kaos-69/Mimisbrunnur/images/light.jpg

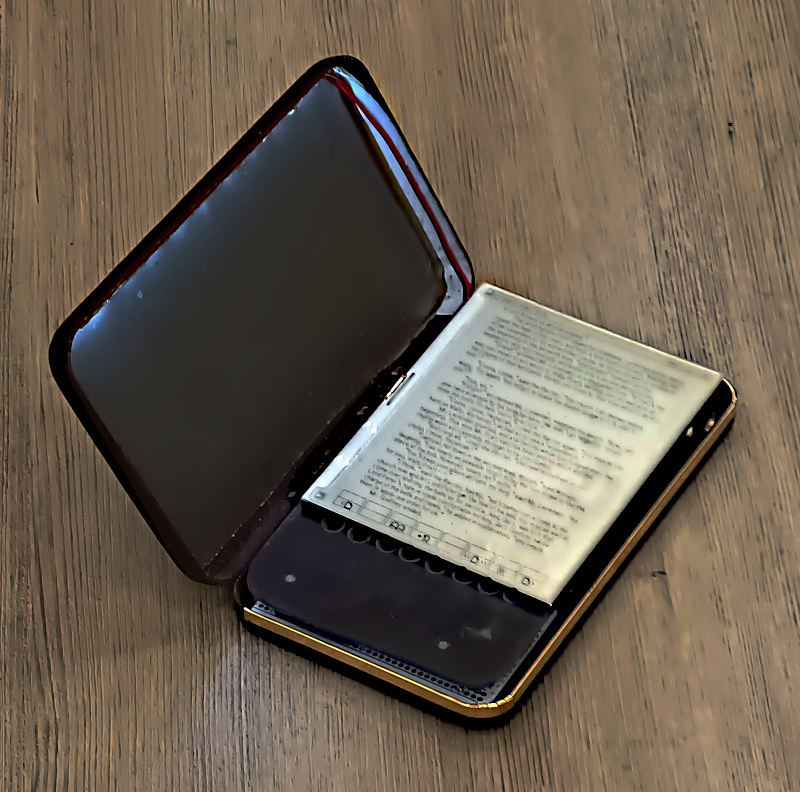
images/light.jpg
