kaos-69/Mimisbrunnur/images/reference.jpg

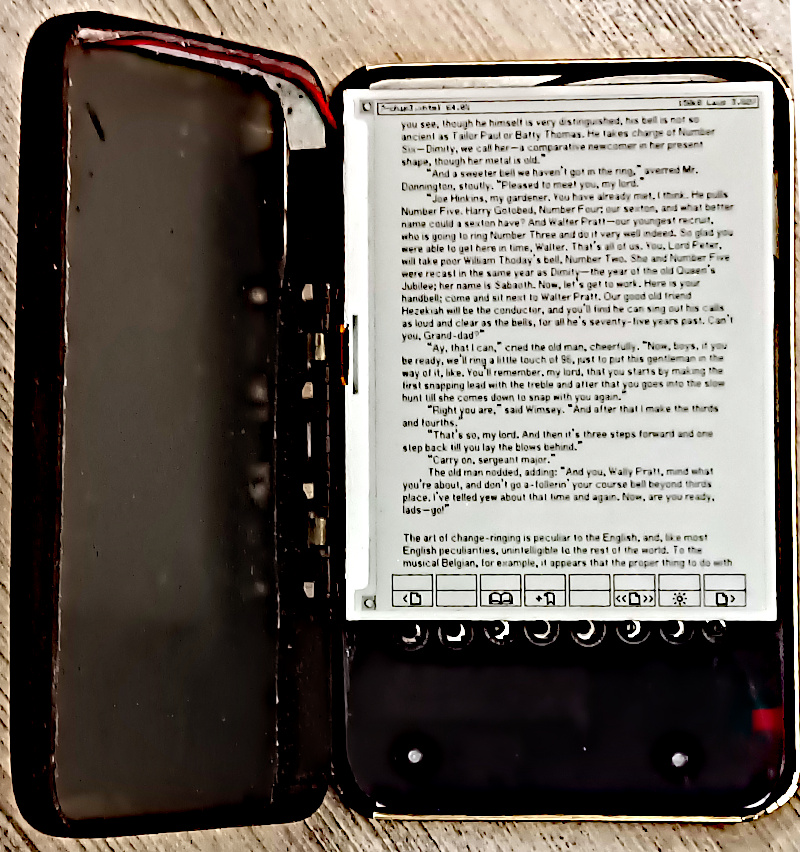
images/reference.jpg
