kaos-69/Mimisbrunnur/docs/INSTRUCTIONS.md

It may sound ass-forwards to provide operating instructions for something that there only exists one example of, and that in a constant flux of development, but I think they can provide a sense of what the reader is and how it works, and thereby whether anyone would want to dive down the rabbit hole and make something similar.

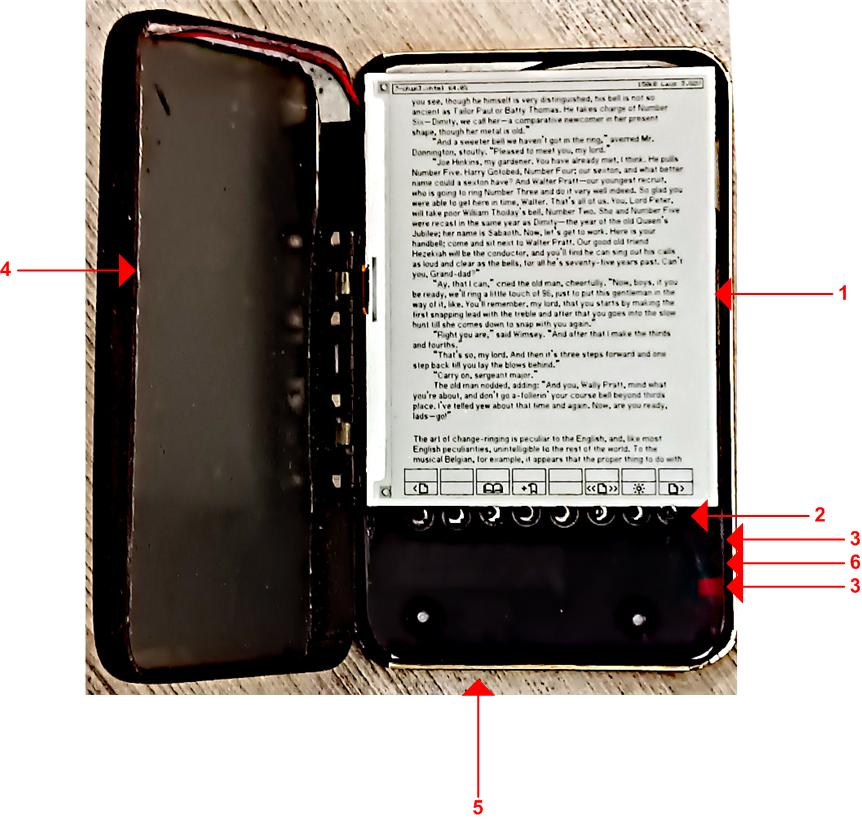
[picture p11: images/Mímisbrunnur - overview.jpg]
Mímisbrunnur overview
<br>**Overview.**  
1: An e-paper display  
2: A set of eight push buttons  
3: Two indicator lights  
4: A reading light  
5: A micro-SD slot/card to hold documents  
6: A USB-C connector for charging and programming  

The two indicators are an amber charge indicator and a red busy indicator, both located near the USB connector. When the busy indicator is lit or flashing the buttons will not work, and the SD card may be in use and should not be removed.

At the bottom of the display is a menu corresponding to the buttons and indicating the function of each one. Each menu item can show an icon, which function is accessed by a short press of the corresponding button (see below). For numbered references on the display (directory items when browsing, or links when reading) there is also a number at the corresponding button. To acess those, hold the button for approx. 2 seconds, or until the busy indicator comes on.

When the reader is started up with a previously unread memory card, you will be presented with a browse display where you can select a document to read. If it is started without a memory card an error message is displayed. For subsequent starts the reader will return you to the document and place you were reading.

When browsing, the reader will show up to eight items (directories and/or documents) at a time. If there are more than eight items you can move between pages with the next and previous buttons. The working path is shown at the top of the screen (/ initially, for root). Items ending with / are directories. In all directories except root you will also find .. for parent directory.

When reading, likewise up to eight links are presented on each page. If there are more than eight links, the page will be curtailed and you will have to move on to the next page for subsequent links.

At the top of the display a status bar is shown. When browsing this shows the current page and number of pages in the current directory. When reading it shows the name of the current document and your place within it (in percent). Always shown is free memory and battery voltage. Note that the status bar is only updated when the display is, so the values may not be current if the reader has been left unused for a substantial time.

## Menu options:

Previous page Previous page. Used when reading or browsing for documents. Note that selecting previous page when reading near the end of a large document can take some time (a matter of econds). This is because the firmware has to scan the entire document up to that point, in order to find the start of the previous page. The busy indicator blinks rapidly while doing this.

Cancel / Back history Cancel / Back history. This is used to cancel or back away from previously selected options. F.x. when following a link within a document, this function will bring you back to your previous place. Similarly, if you started browsing for a new document, this will bring you back to reading where you left off.

Browse / Open document Browse / Open document. This allows you to select a new document for reading. You will start browsing in the directory of the document you were reading. You can return to reading where you left off by using Cancel, but once you have selected a new document, your history is deleted.

Add bookmark Remove bookmark Go to next bookmark Bookmarks. When reading, you can add or remove bookmarks for any page, and go to next bookmark after the current page. If there is no next bookmark, you will go to the first bookmark in the document.

Skip around Skip around. This allows you to skip to several points in the document, which can be useful if you want to quickly find a specific passage.

Reading light Reading light. This will turn on or off the reading light.

Next page Next page. Used when reading or browsing for documents. Unlike the previous page option, this is practically instantaneous, apart from the time it takes to display the new page.
