kaos-69/Mimisbrunnur/images/Mímisbrunnur -  layout.pdf

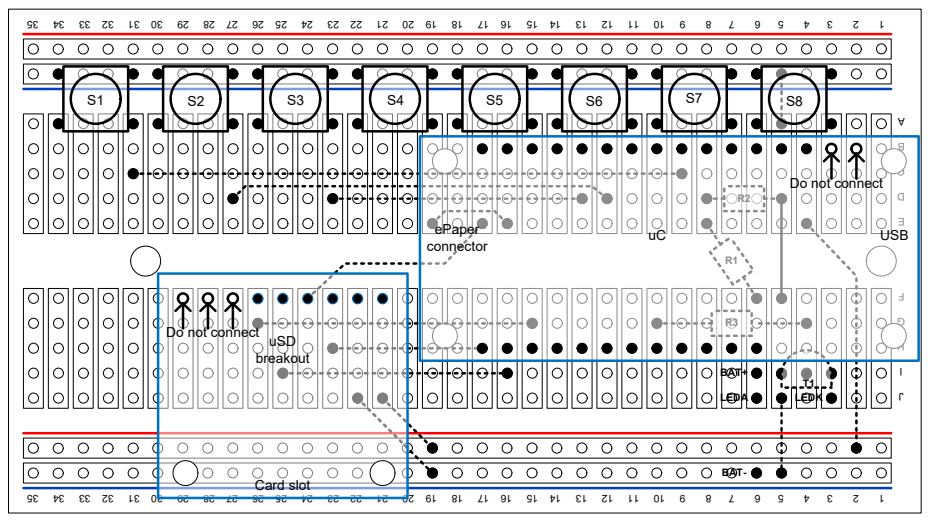
[picture p12: page 1]
LEDA; LEDK; BAT+; BAT-; USB ePaper; connector; uSD breakout; Card slot

Do not connect
