kaos-69/Mimisbrunnur/images/Mímisbrunnur -  diagram.pdf

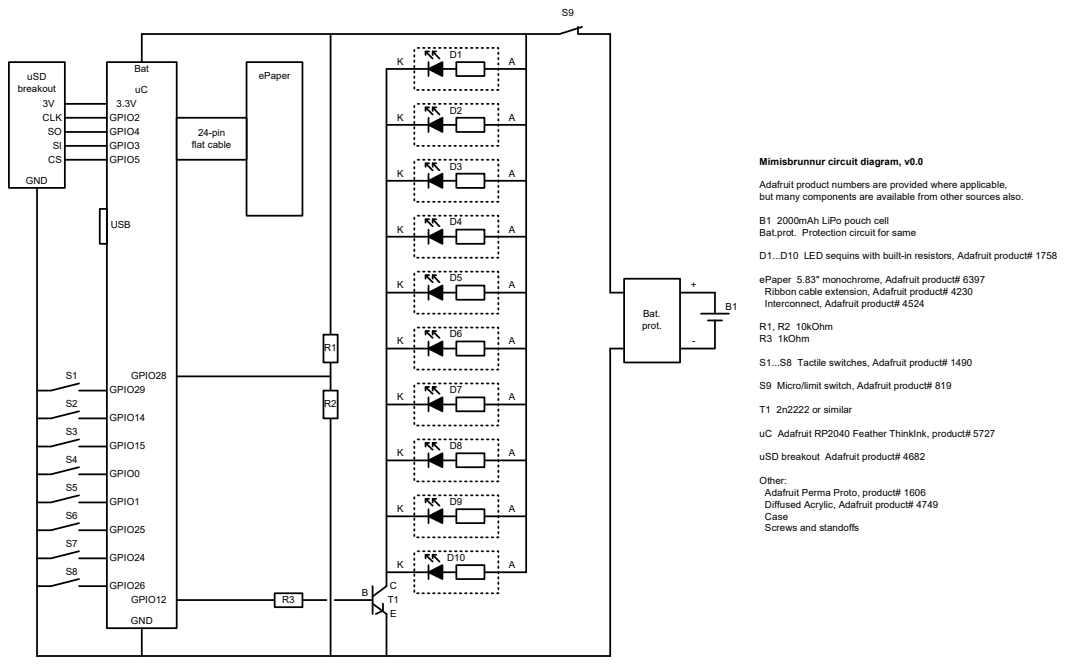
[picture p13: page 1]

Adafruit product numbers are provided where applicable,
but many components are available from other sources also. B1 2000mAh LiPo pouch cell

Bat.prot. Protection circuit for same

D10 LED sequins with built

-in resistors, Adafruit product# 1758

ePaper 5.83" monochrome, Adafruit product# 6397
Ribbon cable extension, Adafruit product# 4230
Interconnect, Adafruit product# 4524

S8 Tactile switches, Adafruit product# 1490

/limit switch, Adafruit product# 819

uC Adafruit RP2040 Feather ThinkInk, product# 5727

uSD breakout Adafruit product# 4682

Other:
Adafruit Perma Proto, product# 1606
Diffused Acrylic, Adafruit product# 4749
Case
Screws and standoffs
