kaos-69/Mimisbrunnur/code/FreeSans-13-1252.h

#pragma once
#include <Adafruit_GFX.h>
/* PROPERTIES

FONT_NAME _FreeSans_
PIXEL_SIZE 13
FONT_ASCENT 10
FONT_DESCENT 3
*/
const uint8_t _FreeSans_Bitmaps[] PROGMEM = {
/* ' ' 0x20 */ 
/* '!' 0x21 */ 0xFE, 0x40, 
/* '"' 0x22 */ 0xB6, 0x80, 
/* '#' 0x23 */ 0x12, 0x12, 0x7F, 0x24, 0x24, 0x24, 0xFE, 0x48, 0x48, 
/* '$' 0x24 */ 0x23, 0xAB, 0x4A, 0x38, 0xA5, 0xAD, 0x5C, 0x40, 
/* '%' 0x25 */ 0x62, 0x49, 0x25, 0x0C, 0x80, 0x80, 0x40, 0x4C, 0x29, 0x24, 0x91, 0x80, 
/* '&' 0x26 */ 0x30, 0x91, 0x22, 0x82, 0x0A, 0x62, 0xC2, 0x8A, 0xE4, 
/* ''' 0x27 */ 0xE0, 
/* '(' 0x28 */ 0x5A, 0xAA, 0x50, 
/* ')' 0x29 */ 0xA5, 0x55, 0xA0, 
/* '*' 0x2A */ 0x5D, 0x50, 
/* '+' 0x2B */ 0x21, 0x3E, 0x42, 0x00, 
/* ',' 0x2C */ 0xF6, 
/* '-' 0x2D */ 0xF8, 
/* '.' 0x2E */ 0xF0, 
/* '/' 0x2F */ 0x08, 0x44, 0x22, 0x11, 0x08, 0x84, 0x00, 
/* '0' 0x30 */ 0x22, 0xA3, 0x18, 0xC6, 0x31, 0x51, 0x00, 
/* '1' 0x31 */ 0x2E, 0x92, 0x49, 0x24, 
/* '2' 0x32 */ 0x74, 0x62, 0x11, 0x11, 0x10, 0x87, 0xC0, 
/* '3' 0x33 */ 0x74, 0x62, 0x13, 0x04, 0x31, 0x8B, 0x80, 
/* '4' 0x34 */ 0x11, 0x8C, 0xA5, 0x4A, 0x5F, 0x10, 0x80, 
/* '5' 0x35 */ 0xFC, 0x21, 0xE8, 0x84, 0x31, 0x8B, 0x80, 
/* '6' 0x36 */ 0x74, 0x61, 0x0F, 0x46, 0x31, 0x8B, 0x80, 
/* '7' 0x37 */ 0xF8, 0x42, 0x21, 0x10, 0x84, 0x42, 0x00, 
/* '8' 0x38 */ 0x74, 0x63, 0x17, 0x46, 0x31, 0x8B, 0x80, 
/* '9' 0x39 */ 0x74, 0x63, 0x18, 0xBC, 0x21, 0x8B, 0x80, 
/* ':' 0x3A */ 0xF0, 0x3C, 
/* ';' 0x3B */ 0xF0, 0x3D, 0x80, 
/* '<' 0x3C */ 0x0C, 0xCC, 0x30, 0x30, 0x30, 
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
/* 'E' 0x45 */ {   210,    7,  10,   9,   1,  -10 },
/* 'F' 0x46 */ {   219,    7,  10,   9,   1,  -10 },
/* 'G' 0x47 */ {   228,    8,  10,  10,   1,  -10 },
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
};

const GFXfont _FreeSans_ PROGMEM = {
(uint8_t*)_FreeSans_Bitmaps,
(GFXglyph*)_FreeSans_Glyphs,
0x20, 0xFF, 16 
};
