kaos-69/Mimisbrunnur/code/FreeSansBold-13-1252.h

#pragma once
#include <Adafruit_GFX.h>
/* PROPERTIES

FONT_NAME _FreeSansBold_
PIXEL_SIZE 13
FONT_ASCENT 10
FONT_DESCENT 3
*/
const uint8_t _FreeSansBold_Bitmaps[] PROGMEM = {
/* ' ' 0x20 */ 
/* '!' 0x21 */ 0xFF, 0xFC, 0xF0, 
/* '"' 0x22 */ 0xCF, 0x3C, 0xC0, 
/* '#' 0x23 */ 0x34, 0x4B, 0xF9, 0x66, 0xCD, 0x3F, 0xA4, 0x58, 
/* '$' 0x24 */ 0x10, 0x79, 0xF2, 0xB5, 0x0F, 0x07, 0x0B, 0xD6, 0xFC, 0xF0, 0x80, 
/* '%' 0x25 */ 0x70, 0x8D, 0x98, 0xC9, 0x0C, 0xB0, 0x72, 0x00, 0x4E, 0x0D, 0x30, 0x93, 0x19, 0x71, 0x1E, 
/* '&' 0x26 */ 0x38, 0x68, 0x68, 0x78, 0x70, 0xFA, 0x9E, 0xCE, 0xFE, 0x7B, 
/* ''' 0x27 */ 0xFC, 
/* '(' 0x28 */ 0x32, 0x6C, 0xCC, 0xCC, 0xC6, 0x23, 
/* ')' 0x29 */ 0xC4, 0x63, 0x33, 0x33, 0x36, 0x4C, 
/* '*' 0x2A */ 0x30, 0xCF, 0xCC, 0xCE, 0x10, 
/* '+' 0x2B */ 0x30, 0xCF, 0xFF, 0x30, 0xC0, 
/* ',' 0x2C */ 0xF6, 
/* '-' 0x2D */ 0xFF, 0xC0, 
/* '.' 0x2E */ 0xF0, 
/* '/' 0x2F */ 0x25, 0xB4, 0xB6, 0x90, 
/* '0' 0x30 */ 0x38, 0xF9, 0x16, 0x3C, 0x78, 0xF1, 0xA2, 0x7C, 0x70, 
/* '1' 0x31 */ 0x17, 0xF3, 0x33, 0x33, 0x33, 
/* '2' 0x32 */ 0x38, 0xD9, 0x1A, 0x30, 0xC3, 0x8E, 0x30, 0x7F, 0xFC, 
/* '3' 0x33 */ 0x38, 0xD9, 0x10, 0x61, 0x81, 0x81, 0xE3, 0x7C, 0x70, 
/* '4' 0x34 */ 0x1C, 0x38, 0xF1, 0x64, 0xC9, 0xBF, 0xFF, 0x0C, 0x18, 
/* '5' 0x35 */ 0x7C, 0xF9, 0x03, 0xC7, 0xC0, 0xC1, 0xE3, 0x7C, 0x70, 
/* '6' 0x36 */ 0x3C, 0xF9, 0x02, 0x0F, 0xDC, 0xF1, 0xA3, 0x7C, 0x70, 
/* '7' 0x37 */ 0xFF, 0xFC, 0x30, 0x41, 0x82, 0x0C, 0x18, 0x30, 0x60, 
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
/* 'E' 0x45 */ {   255,    7,  10,   9,   1,  -10 },
/* 'F' 0x46 */ {   264,    7,  10,   8,   1,  -10 },
/* 'G' 0x47 */ {   273,    8,  10,  10,   1,  -10 },
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
};

const GFXfont _FreeSansBold_ PROGMEM = {
(uint8_t*)_FreeSansBold_Bitmaps,
(GFXglyph*)_FreeSansBold_Glyphs,
0x20, 0xFF, 17 
};
