kaos-69/Mimisbrunnur/code/FreeSansBoldOblique-13-1252.h

#pragma once
#include <Adafruit_GFX.h>
/* PROPERTIES

FONT_NAME _FreeSansBoldOblique_
PIXEL_SIZE 13
FONT_ASCENT 10
FONT_DESCENT 3
*/
const uint8_t _FreeSansBoldOblique_Bitmaps[] PROGMEM = {
/* ' ' 0x20 */ 
/* '!' 0x21 */ 0x6D, 0xA4, 0x86, 0xC0, 
/* '"' 0x22 */ 0x4E, 0xE4, 
/* '#' 0x23 */ 0x09, 0x0B, 0x3F, 0x16, 0x36, 0x24, 0x7E, 0x68, 0x48, 0xD8, 
/* '$' 0x24 */ 0x08, 0x7D, 0xBB, 0x87, 0x07, 0x87, 0x6A, 0xED, 0xF0, 0x81, 0x00, 
/* '%' 0x25 */ 0x71, 0x26, 0x89, 0x23, 0xD0, 0x0B, 0x85, 0xB1, 0x4C, 0x92, 0x47, 0x00, 
/* '&' 0x26 */ 0x1E, 0x36, 0x36, 0x3C, 0x18, 0x7D, 0xCF, 0xC6, 0xFE, 0x7B, 
/* ''' 0x27 */ 0x78, 
/* '(' 0x28 */ 0x19, 0x88, 0xC4, 0x63, 0x18, 0xC6, 0x30, 0x80, 
/* ')' 0x29 */ 0x30, 0x84, 0x31, 0x8C, 0x46, 0x31, 0x11, 0x80, 
/* '*' 0x2A */ 0x2F, 0x4A, 
/* '+' 0x2B */ 0x18, 0x33, 0xFF, 0xF3, 0x06, 0x00, 
/* ',' 0x2C */ 0x6C, 0xE0, 
/* '-' 0x2D */ 0xFF, 0xC0, 
/* '.' 0x2E */ 0xF0, 
/* '/' 0x2F */ 0x08, 0x44, 0x22, 0x11, 0x08, 0x44, 0x00, 
/* '0' 0x30 */ 0x1C, 0x7D, 0x9B, 0x3C, 0x78, 0xF3, 0x66, 0xF8, 0xE0, 
/* '1' 0x31 */ 0x18, 0xFF, 0xE3, 0x18, 0xC4, 0x63, 0x00, 
/* '2' 0x32 */ 0x1C, 0x7D, 0x9B, 0x30, 0x43, 0x8C, 0x30, 0xFD, 0xF8, 
/* '3' 0x33 */ 0x3C, 0xFD, 0x98, 0x21, 0xC1, 0x83, 0x66, 0xFC, 0xF0, 
/* '4' 0x34 */ 0x06, 0x1C, 0x71, 0xE2, 0xC9, 0xBF, 0xFE, 0x18, 0x30, 
/* '5' 0x35 */ 0x3E, 0x7C, 0x83, 0x07, 0xC9, 0x81, 0x66, 0xF8, 0xE0, 
/* '6' 0x36 */ 0x1C, 0x6D, 0x83, 0x07, 0xD9, 0xB1, 0x66, 0xFC, 0xF0, 
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
/* 'F' 0x46 */ {   285,    9,  10,  10,   1,  -10 },
/* 'G' 0x47 */ {   297,   10,  10,  11,   1,  -10 },
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
};

const GFXfont _FreeSansBoldOblique_ PROGMEM = {
(uint8_t*)_FreeSansBoldOblique_Bitmaps,
(GFXglyph*)_FreeSansBoldOblique_Glyphs,
0x20, 0xFF, 16 
};
