kaos-69/Mimisbrunnur/code/FreeSansOblique-13-1252.h

#pragma once
#include <Adafruit_GFX.h>
/* PROPERTIES

FONT_NAME _FreeSansOblique_
PIXEL_SIZE 13
FONT_ASCENT 10
FONT_DESCENT 3
*/
const uint8_t _FreeSansOblique_Bitmaps[] PROGMEM = {
/* ' ' 0x20 */ 
/* '!' 0x21 */ 0x25, 0x24, 0xA4, 0x10, 
/* '"' 0x22 */ 0x4E, 0xE4, 
/* '#' 0x23 */ 0x12, 0x29, 0xF9, 0x22, 0x89, 0x3F, 0x28, 0x90, 
/* '$' 0x24 */ 0x08, 0x38, 0xAA, 0x95, 0x06, 0x06, 0x0A, 0xA5, 0x49, 0xE1, 0x00, 
/* '%' 0x25 */ 0x30, 0x52, 0x24, 0x90, 0xC8, 0x04, 0x02, 0x01, 0x30, 0x92, 0x44, 0xA0, 0xC0, 
/* '&' 0x26 */ 0x1C, 0x64, 0x91, 0xE1, 0x0F, 0x72, 0xC2, 0xCC, 0xE4, 
/* ''' 0x27 */ 0xE0, 
/* '(' 0x28 */ 0x11, 0x22, 0x44, 0x88, 0x84, 0x44, 
/* ')' 0x29 */ 0x22, 0x21, 0x11, 0x11, 0x12, 0x24, 0x80, 
/* '*' 0x2A */ 0x2F, 0x4A, 
/* '+' 0x2B */ 0x08, 0x20, 0x47, 0xF1, 0x02, 0x08, 0x00, 
/* ',' 0x2C */ 0x58, 
/* '-' 0x2D */ 0xF8, 
/* '.' 0x2E */ 0x80, 
/* '/' 0x2F */ 0x08, 0x44, 0x22, 0x11, 0x08, 0x84, 0x00, 
/* '0' 0x30 */ 0x1C, 0x4D, 0x0A, 0x14, 0x78, 0xA1, 0x42, 0xC8, 0xE0, 
/* '1' 0x31 */ 0x27, 0x96, 0x92, 0x58, 
/* '2' 0x32 */ 0x1C, 0x45, 0x08, 0x10, 0x43, 0x0C, 0x20, 0x81, 0xF8, 
/* '3' 0x33 */ 0x1C, 0x4D, 0x08, 0x21, 0x80, 0x81, 0x42, 0x88, 0xE0, 
/* '4' 0x34 */ 0x04, 0x31, 0xC5, 0x2D, 0x28, 0xBF, 0x08, 0x40, 
/* '5' 0x35 */ 0x3E, 0x41, 0x83, 0xE4, 0x40, 0x81, 0x42, 0x88, 0xE0, 
/* '6' 0x36 */ 0x1C, 0x45, 0x02, 0x07, 0xD8, 0xB1, 0x42, 0xCC, 0xF0, 
/* '7' 0x37 */ 0xFE, 0x08, 0x20, 0xC1, 0x04, 0x18, 0x20, 0xC1, 0x00, 
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
/* 'F' 0x46 */ {   267,    8,  10,   9,   1,  -10 },
/* 'G' 0x47 */ {   277,    9,  10,  10,   1,  -10 },
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
};

const GFXfont _FreeSansOblique_ PROGMEM = {
(uint8_t*)_FreeSansOblique_Bitmaps,
(GFXglyph*)_FreeSansOblique_Glyphs,
0x20, 0xFF, 17 
};
