kaos-69/Mimisbrunnur/code/icons.h

int iconwidth=48;
int iconheight=16;

// 'bmadd', 48x16px
const unsigned char iconbmadd [] PROGMEM = {
	0x00, 0x00, 0x00, 0x7f, 0x80, 0x00, 0x00, 0x00, 0x01, 0xff, 0xe0, 0x00, 0x00, 0x00, 0x01, 0xe0, 
	0x60, 0x00, 0x00, 0x00, 0x03, 0xe0, 0x30, 0x00, 0x00, 0x01, 0x83, 0xf0, 0x30, 0x00, 0x00, 0x01, 
	0x80, 0x30, 0x30, 0x00, 0x00, 0x01, 0x80, 0x30, 0x30, 0x00, 0x00, 0x0f, 0xf0, 0x30, 0x30, 0x00, 
	0x00, 0x0f, 0xf0, 0x30, 0x30, 0x00, 0x00, 0x01, 0x80, 0x30, 0x30, 0x00, 0x00, 0x01, 0x80, 0x30, 
	0x30, 0x00, 0x00, 0x01, 0x80, 0x33, 0x30, 0x00, 0x00, 0x00, 0x00, 0x37, 0xb0, 0x00, 0x00, 0x00, 
	0x00, 0x3c, 0xf0, 0x00, 0x00, 0x00, 0x00, 0x38, 0x70, 0x00, 0x00, 0x00, 0x00, 0x30, 0x30, 0x00
};
// 'bmgoto', 48x16px
const unsigned char iconbmgoto [] PROGMEM = {
	0x00, 0x00, 0x00, 0xff, 0x00, 0x00, 0x00, 0x00, 0x03, 0xff, 0xc0, 0x00, 0x00, 0x00, 0x03, 0xc0, 
	0xc0, 0x00, 0x00, 0x04, 0x07, 0xc0, 0x60, 0x00, 0x00, 0x06, 0x07, 0xe0, 0x60, 0x00, 0x00, 0x03, 
	0x00, 0x60, 0x60, 0x00, 0x00, 0x01, 0x80, 0x60, 0x60, 0x00, 0x00, 0x00, 0xc0, 0x60, 0x60, 0x00, 
	0x00, 0x00, 0xc0, 0x60, 0x60, 0x00, 0x00, 0x01, 0x80, 0x60, 0x60, 0x00, 0x00, 0x03, 0x00, 0x60, 
	0x60, 0x00, 0x00, 0x06, 0x00, 0x66, 0x60, 0x00, 0x00, 0x04, 0x00, 0x6f, 0x60, 0x00, 0x00, 0x00, 
	0x00, 0x79, 0xe0, 0x00, 0x00, 0x00, 0x00, 0x70, 0xe0, 0x00, 0x00, 0x00, 0x00, 0x60, 0x60, 0x00
};
// 'bmrem', 48x16px
const unsigned char iconbmrem [] PROGMEM = {
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
	0x60, 0xc0, 0x60, 0x06, 0x03, 0x06, 0x30, 0x60, 0x60, 0x06, 0x06, 0x0c, 0x18, 0x30, 0x60, 0x06, 
	0x0c, 0x18, 0x0c, 0x18, 0x60, 0x06, 0x18, 0x30, 0x04, 0x08, 0x60, 0x06, 0x10, 0x20, 0x00, 0x00, 
	0x60, 0x06, 0x00, 0x00, 0x00, 0x00, 0x7f, 0xfe, 0x00, 0x00, 0x00, 0x00, 0x7f, 0xfe, 0x00, 0x00
};

// Array of all bitmaps for convenience. (Total bytes used to store images in PROGMEM = 1008)
const int iconallArray_LEN = 9;
const unsigned char* iconallArray[9] = {
	iconbmadd,
	iconbmgoto,
	iconbmrem,
	iconcancel,
	iconlight,
	iconnext,
	iconopen,
	iconprev,
	iconskip
};
